cormoran/TPIP3SizeMotorBoard/README.md

# TPIP3SizeMotorBoard
ArduinoUnoCompatible Board for four wheel robot control (with TPIP3 image board)

[Document](https://cormoran.github.io/TPIP3SizeMotorBoard/)
