cormoran/TPIP3SizeMotorBoard/hardware/readme.md

# 2016年度４号機向け モータ制御回路

## 機能

* ４つのモータを正転、逆転、停止、空転、速度調整
* ２つのサーボモータを制御
* 赤外線LED, 受信機
* 温度センサー
* 状態表示用LED 2つ
* VCC,GND出力付きアナログ入力対応汎用ポート 4つ （ガスセンサ等を接続可能）
* 汎用ディジタルIOポート 4つ（二つはスイッチとポート兼用）
* スイッチ入力 4つ（２つはIOポート兼用）
* Groveポート(I2C)
* シリアル通信ポート
* バッテリー電圧監視
* USBシリアル変換IC搭載、Arduino DEIによる書き込み対応
* USB給電・バッテリー給電自動切り替え（バッテリー優先）

など

一応2016年度 3号機向けだが、部内ロボコン等にも使用できるように色々付けてある

## 形状

* TPIP3の金属部分と完全に同じ大きさに設計
* ポートは全て横向きに設置することで高さを削減
