cormoran/TPIP3SizeMotorBoard/document/external-library.md

# 依存ライブラリのインストール

以下のライブラリを入れておくと次で入れるサンプルをコンパイルできる

- [Adafruit-PWM-Servo-Driver-Library](https://github.com/adafruit/Adafruit-PWM-Servo-Driver-Library)
- [DHT-sensor-library](https://github.com/adafruit/DHT-sensor-library)
- [IRremote](https://github.com/z3t0/Arduino-IRremote)

MacのArduinoIDEなら以下のようにたどってライブラリマネージャを開く．

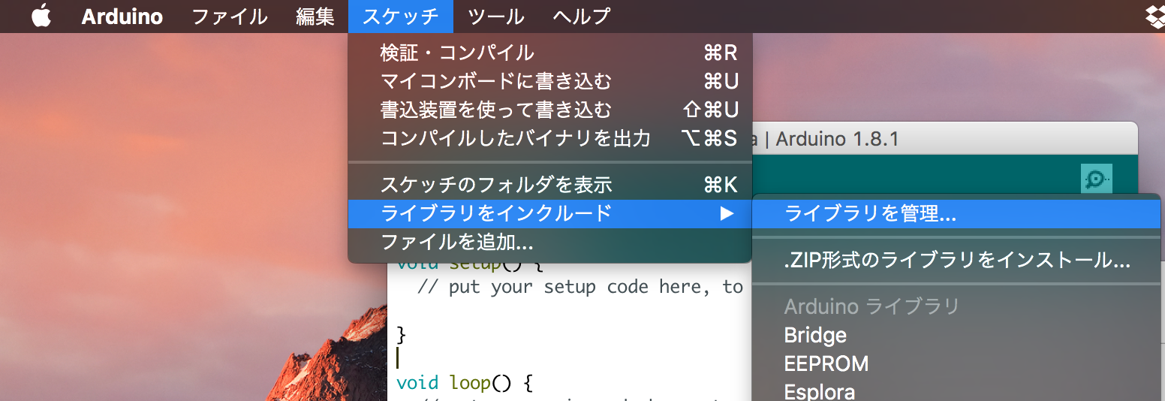
[picture p3: document/assets/library-manager.png]


それっぽく検索すると出てくるのでインストールを押すと勝手に入れてくれる．
