cormoran/TPIP3SizeMotorBoard/document/SUMMARY.md

# TPIP3サイズのArduino互換ボード

* [イントロダクション](README.md)
* [必要な部品](parts.md)
* [制作方法](build.md)
* [ArduinoIDEのインストール](arduino-ide.md)
* [依存ライブラリのインストール](external-library.md)
* [ボードの登録](assign-board.md)
* [テストプログラムの実行](test-program.md)
* [ライブラリのリファレンス](library.md)

---

* 関連リンク

    * [Github](https://github.com/cormoran/TPIP3SizeMotorBoard)
    * [神戸大学ロボット研究会](http://rokko-oroshi.xrea.jp)
    * [TPIP Wiki](http://wiki.tpip-dev.org)
    * [レスキューロボットコンテスト](https://www.rescue-robot-contest.org)

---

* [ノート](note.md)
