cormoran/TPIP3SizeMotorBoard/docs/arduino-ide.md

# Arduino IDEのインストール

インストールしましょう．

[多分ここから可能](https://www.arduino.cc/en/Main/Software)

内部分裂で ardino.cc と arduino.org があって，両方からダウンロードできるが，色々ちょっと違うと思われる．
