cormoran/TPIP3SizeMotorBoard/docs/_book/note.md

# 設計時の話

- Kicadで設計（それまでeagle使いだったが，基板サイズ制限で移行）
- elecrowに発注（自分はelecrowとSwitchSciencePCBしか使ったことない）
- 突貫設計なので...
