cormoran/TPIP3SizeMotorBoard/docs/_book/assets/board_back.jpg

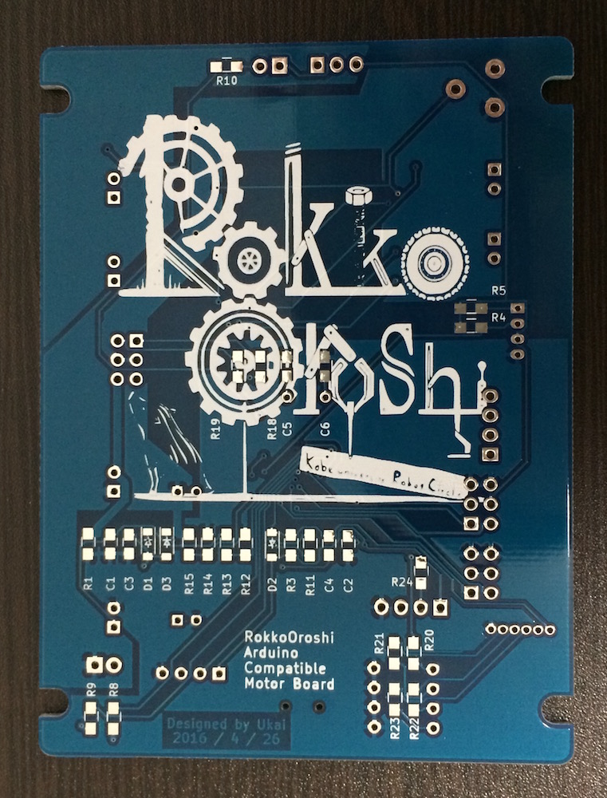
docs/_book/assets/board_back.jpg
