cormoran/TPIP3SizeMotorBoard/docs/_book/assets/board_front.jpg

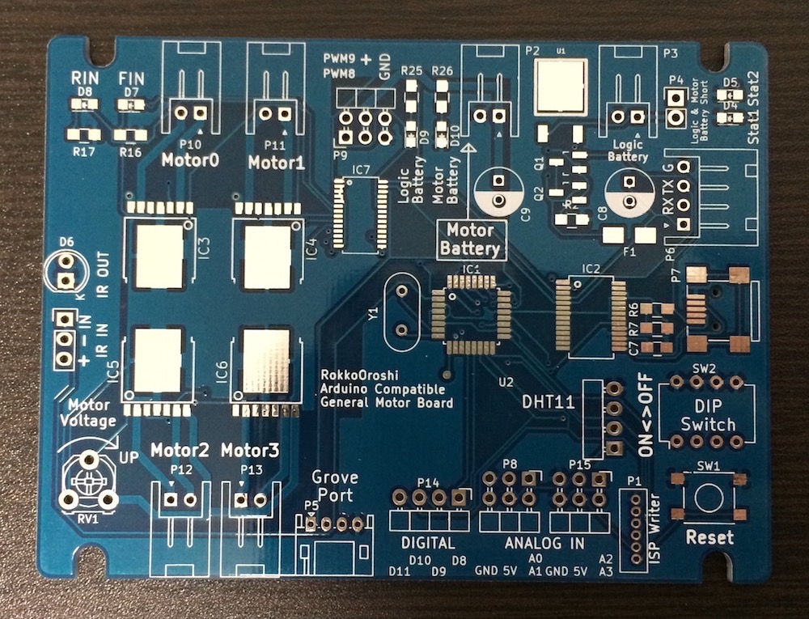
docs/_book/assets/board_front.jpg
