cormoran/TPIP3SizeMotorBoard/hardware/board_front.jpg

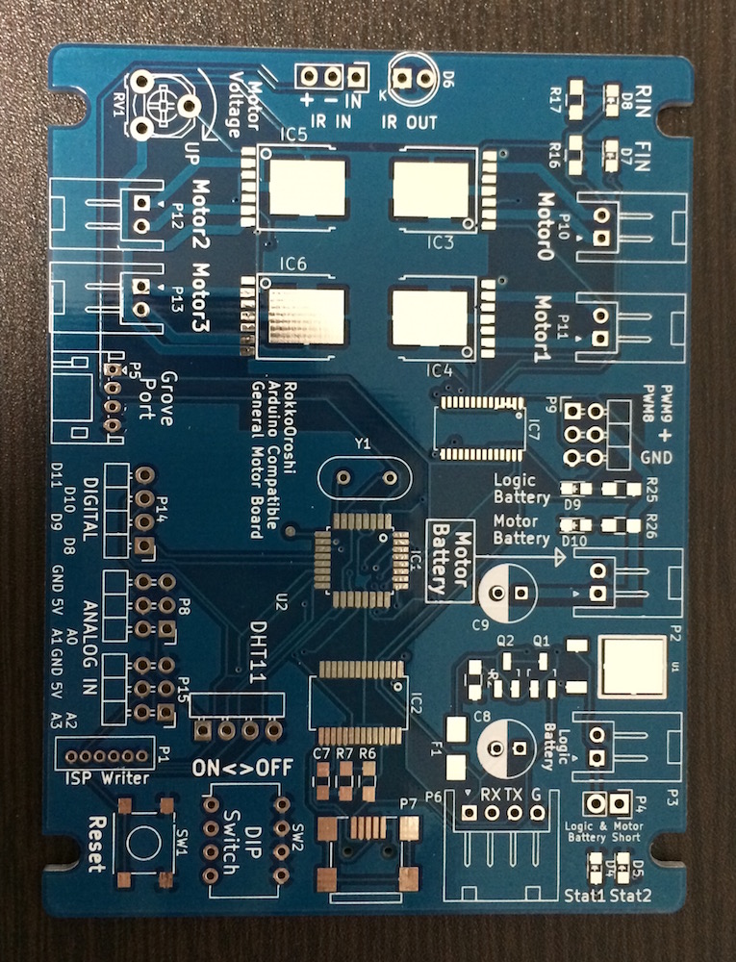
hardware/board_front.jpg
