cormoran/TPIP3SizeMotorBoard/docs/build.md

# 制作方法

昔書き殴った文章そのままです．

1. チップ抵抗の取り付け

    パーツリストの抵抗R1~R26を取り付ける

    R1はモーターのGNDとマイコン側のGNDを接続するためのブリッジで、半田でジャンプしておけば良い

    抵抗は熱に強く、極性がないので、ここで小さい部品の半田付けに慣れる。

	チップ部品は、基板の片方のランドに半田を先につけておいて、それを溶かしながらチップの片方を載せる（文では書きにくい）、その後もう片方を半田付けする、という方法がやりやすいと思う。

2. チップコンデンサの取り付け

	 抵抗と同様の要領でコンデンサC1~C7を取り付ける。

3. ダイオードの取り付け（極性あり）

    D1~D3にチップダイオードを取り付ける。極性があるので注意（線の位置を基板の絵と合わせれば良いはず）

4. LEDの取り付け（極性あり、熱に特に弱い）

	D4~D10にチップダイオードを取り付ける。極性がある&熱に特に弱いので注意。

    また、色が違うとLEDに印刷されたマークが同じなのに極が逆になっているということがあるので注意！！

5. その他部品の取り付け

	 一通り取り付けて慣れてきたはずなので好きな順につけていけば良い。

	気をつける点として、熱に弱い部品はできるだけ後にする、極性がある部品は注意する、他の部品の取り付けの邪魔になるような部品はできるだけ後回しにする、等。

	マイコン等のICは、先にランドに半田を塗っておいて、パーツを上に乗せて、半田ごてを押し付けて溶かしつけるのが、ブリッジしにくくて良いと思う。

    オススメの順番（適当）

    - モータードライバ
    - 電圧変換IC（三端子レギュレータ）
    - FET
	- ポリスイッチ

    - atmega328p
    - PCA9685
    - FT232RL
	
    - その他の表面実装部品
	- USB
    - その他の大きい部品
