cormoran/TPIP3SizeMotorBoard/hardware/board-back.pdf

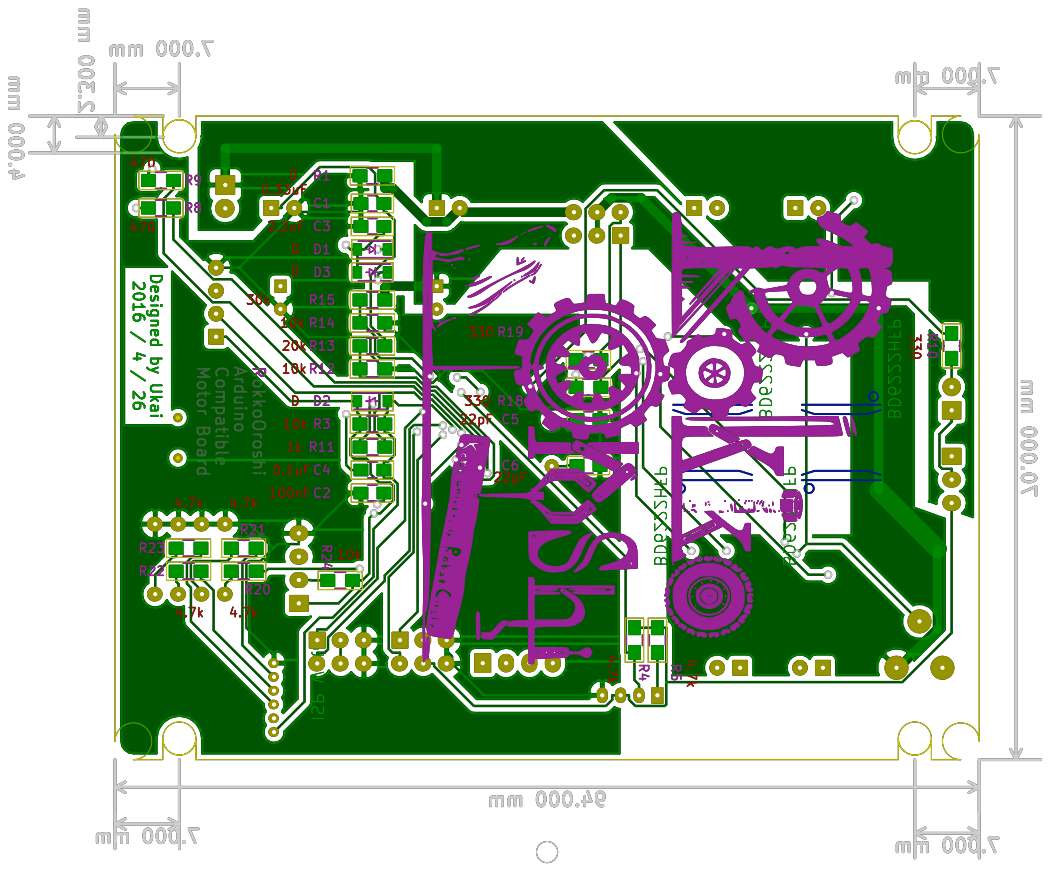
[picture p10: page 1]
