cormoran/TPIP3SizeMotorBoard/hardware/board-front.pdf

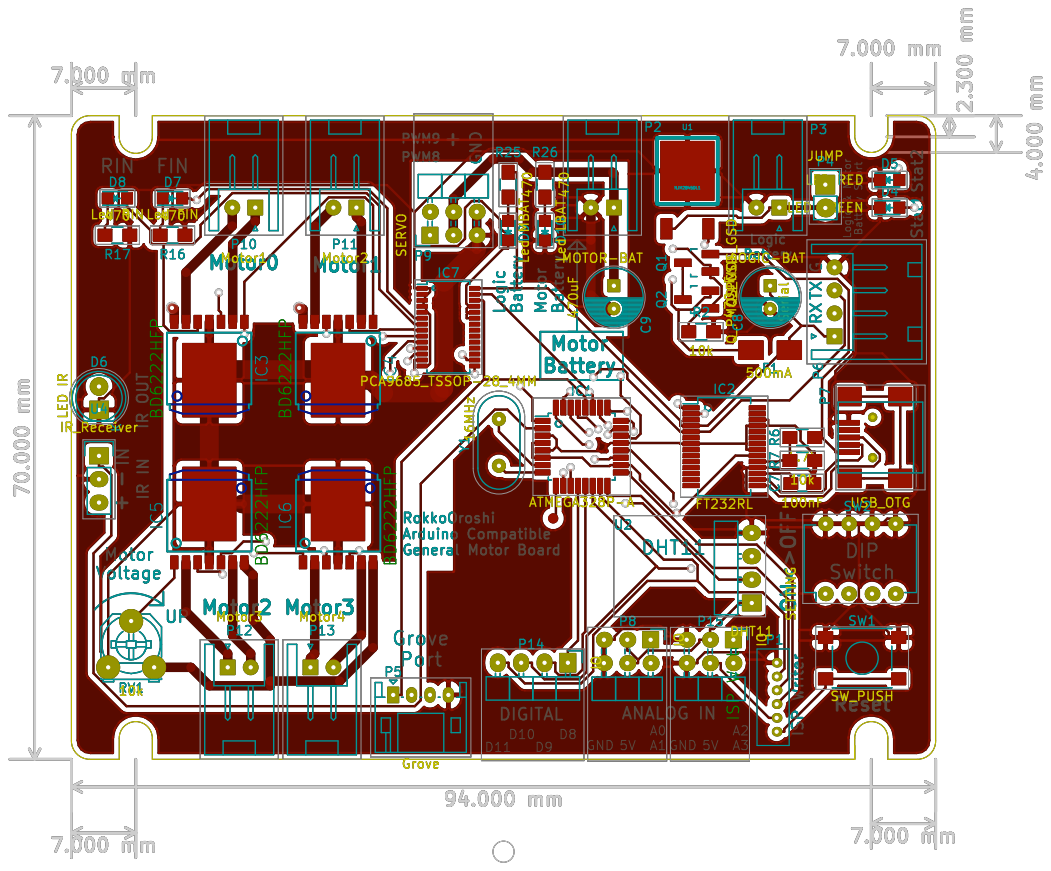
[picture p11: page 1]
