cormoran/TPIP3SizeMotorBoard/docs/assets/sch.pdf

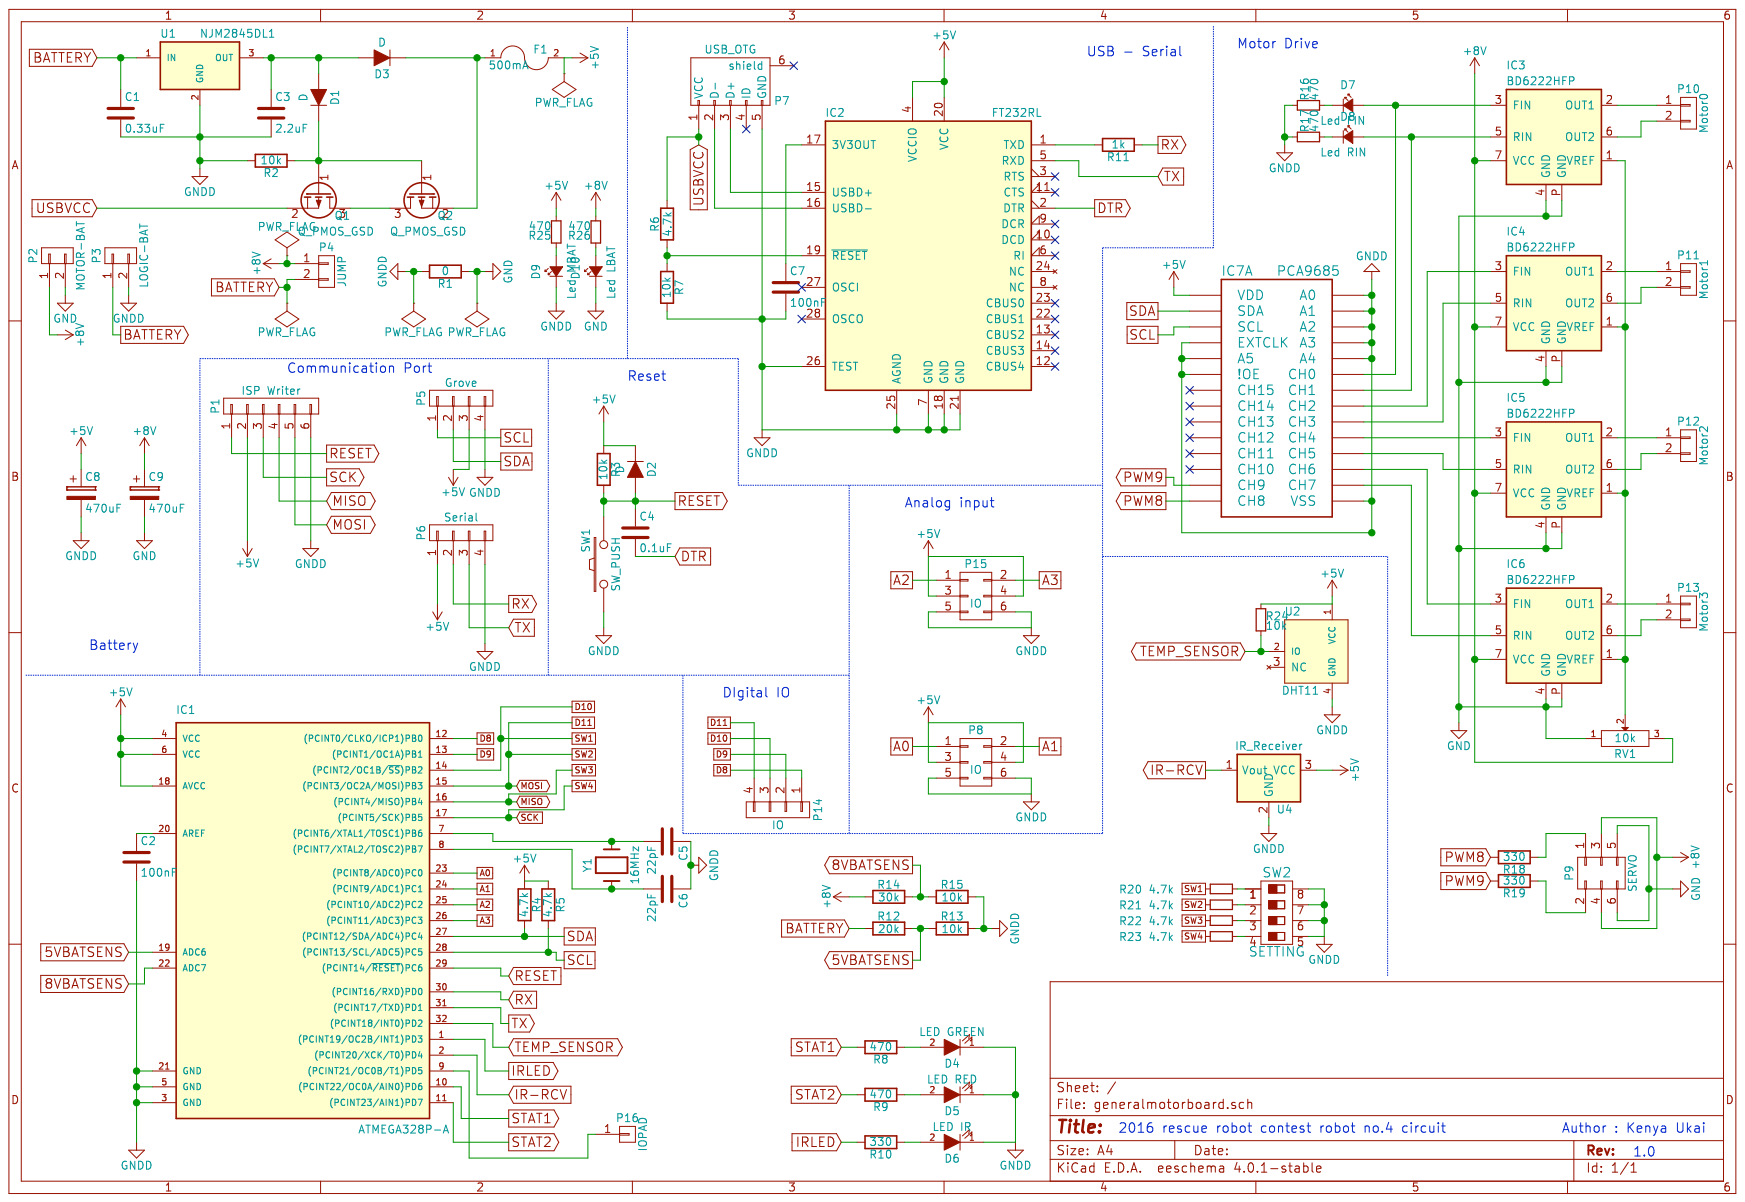
[picture p12: page 1]
