cormoran/TPIP3SizeMotorBoard/(list of files, drawings)

Other design files:
hardware/generalmotorboard.dsn
