cormoran/TPIP3SizeMotorBoard/hardware/generalmotorboard.kicad_pcb

## KiCad design hardware/generalmotorboard.kicad_pcb (2016-05-10)

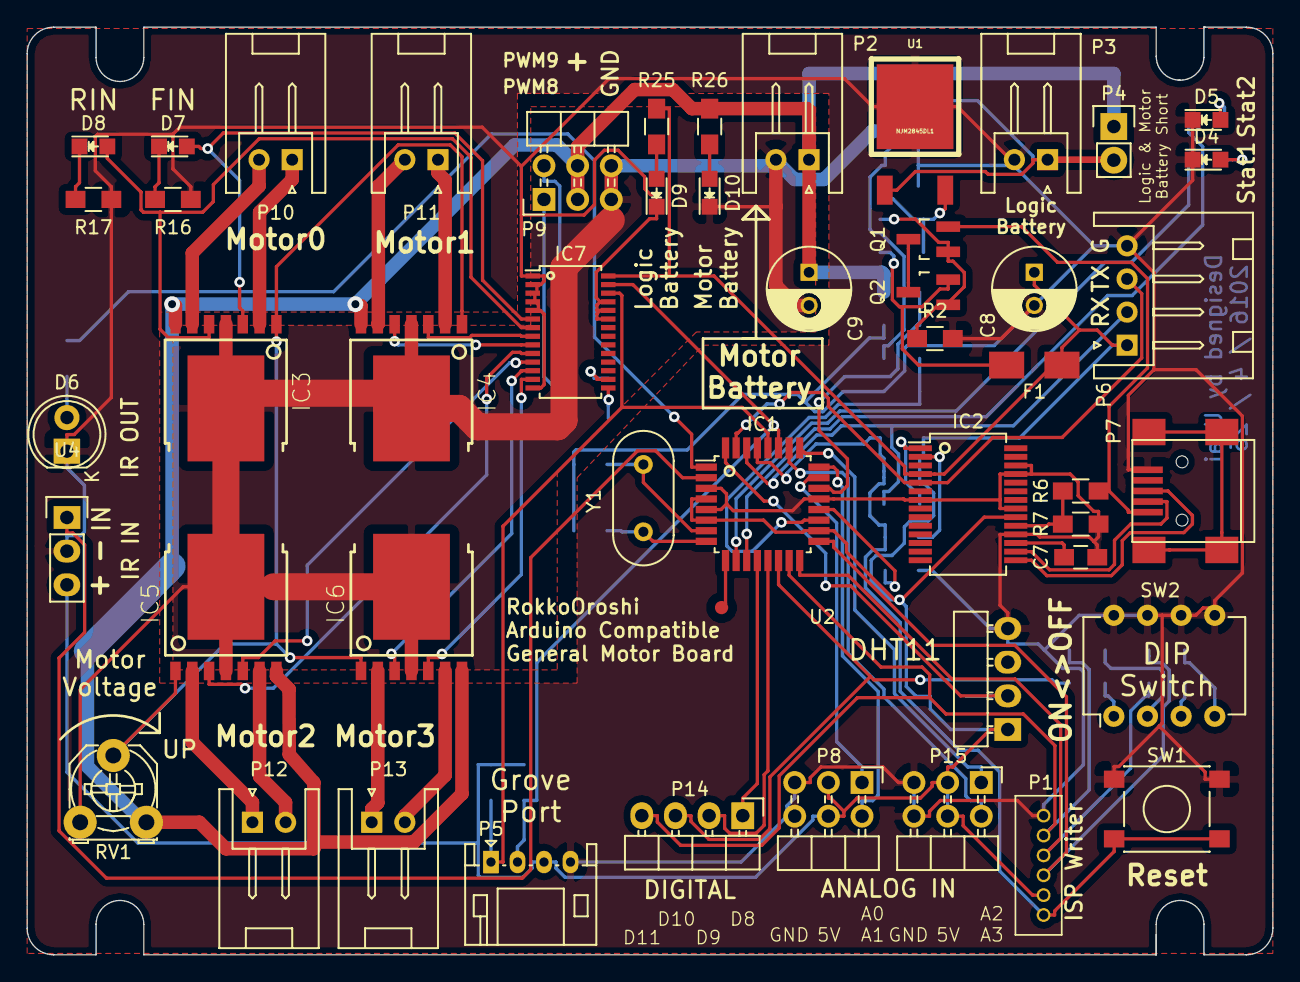
[picture p13: board generalmotorboard.kicad_pcb from above]

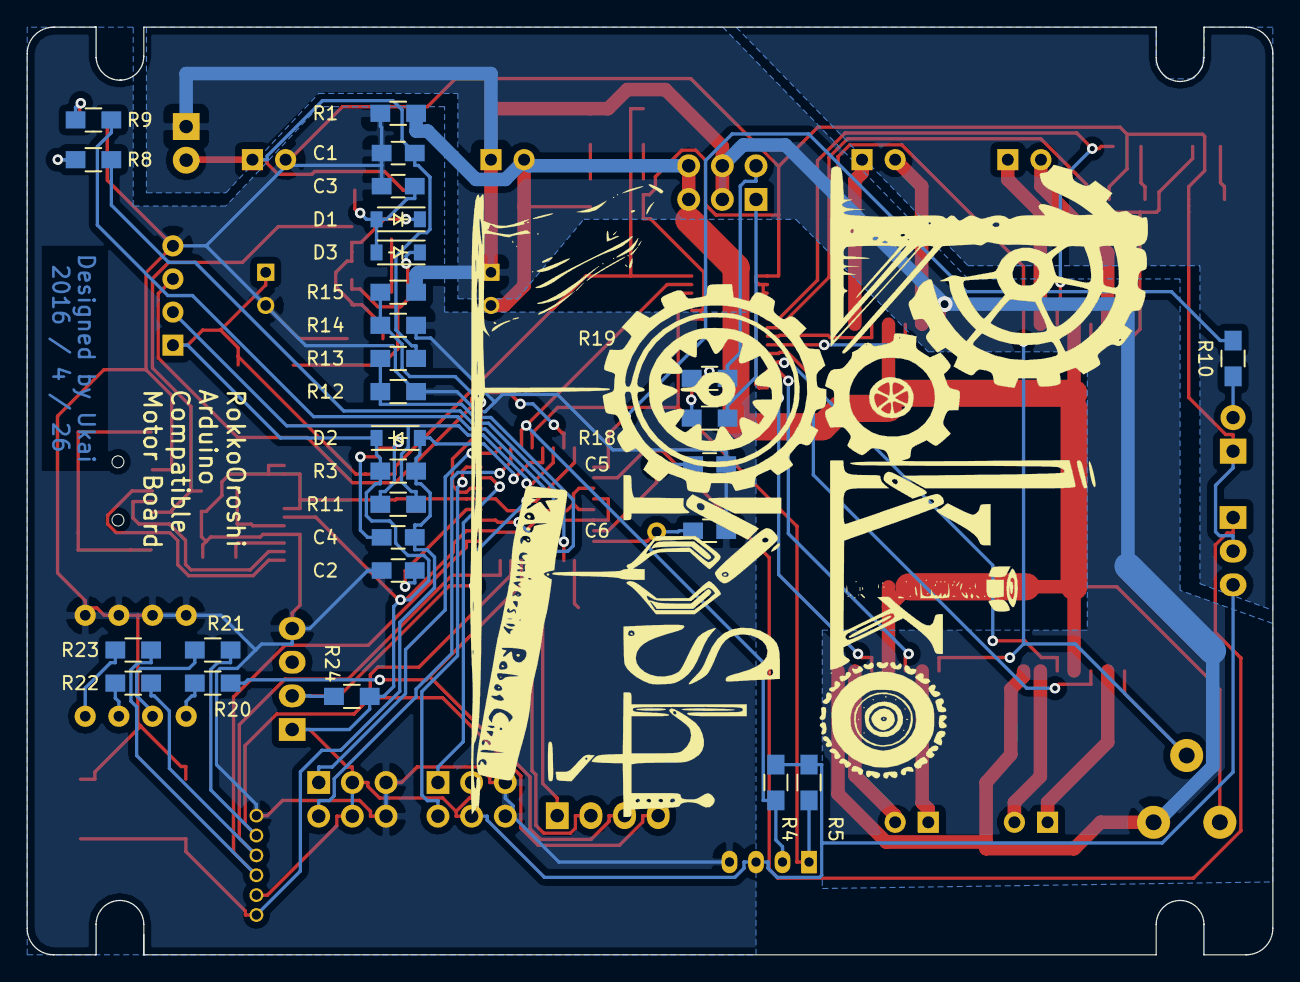
[picture p14: board generalmotorboard.kicad_pcb from below]

Board: 2 copper layers, 94.0 x 70.0 mm, 78 parts (28 on the bottom side), 74 nets.

Parts:
C1: 0.33uF; C_0805_HandSoldering
C2, C7: 100nF; C_0805_HandSoldering
C3: 2.2uF; C_0805_HandSoldering
C4: 0.1uF; C_0805_HandSoldering
C5, C6: 22pF; C_0805_HandSoldering
C8, C9: 470uF; C_Radial_D6.3_L11.2_P2.5
D1, D2, D3: D; SOD-123
D4: LED GREEN; LED_0805
D5: LED RED; LED_0805
D6: LED IR; LED-5MM
D7: Led FIN; LED_0805
D8: Led RIN; LED_0805
D9: Led MBAT; LED_0805
D10: Led LBAT; LED_0805
F1: 500mA; Fuse_SMD1206_HandSoldering
IC1: ATMEGA328P-A; TQFP-32_7x7mm_Pitch0.8mm
IC2: FT232RL; SSOP-28_5.3x10.2mm_Pitch0.65mm
IC3, IC4, IC5, IC6: BD6222HFP; HRP7
IC7: PCA9685_TSSOP-28_4MM; TSSOP-28_4.4x9.7mm_Pitch0.65mm
P1: ISP Writer; B6B-ZR
P2: MOTOR-BAT; JST_XH_S2B-XH-A_02x2.50mm_Angled
P3: LOGIC-BAT; JST_XH_S2B-XH-A_02x2.50mm_Angled
P4: JUMP; Pin_Header_Straight_1x02
P5: Grove; JST_PH_S4B-PH-K_04x2.00mm_Angled
P6: Serial; JST_XH_S4B-XH-A_04x2.50mm_Angled
P7: USB_OTG; USB_Mini-B
P8, P15: IO; Pin_Header_Angled_2x03_without_pin_show
P9: SERVO; Pin_Header_Angled_2x03_without_pin_show
P10: Motor1; JST_XH_S2B-XH-A_02x2.50mm_Angled
P11: Motor2; JST_XH_S2B-XH-A_02x2.50mm_Angled
P12: Motor3; JST_XH_S2B-XH-A_02x2.50mm_Angled
P13: Motor4; JST_XH_S2B-XH-A_02x2.50mm_Angled
P14: IO; Pin_Header_Angled_1x04_without_pin_show
P16: IOPAD; Fiducial_Mark
Q1, Q2: Q_PMOS_GSD; SOT-23_Handsoldering
R1: 0; R_0805_HandSoldering
R2, R3, R7, R13, R15, R24: 10k; R_0805_HandSoldering
R4, R5, R6, R20, R21, R22, R23: 4.7k; R_0805_HandSoldering
R8, R9, R16, R17, R25, R26: 470; R_0805_HandSoldering
R10, R18, R19: 330; R_0805_HandSoldering
R11: 1k; R_0805_HandSoldering
R12: 20k; R_0805_HandSoldering
R14: 30k; R_0805_HandSoldering
RV1: 10k; Potentiometer_Triwood_RM-065
SW1: SW_PUSH; SW_SPST_PTS645
SW2: SETTING; DIP-8_W7.62mm
U1: NJM2845DL1; TO-252-3
U2: DHT11
U4: IR_Receiver; Pin_Header_Straight_1x03
Y1: 16MHz; HC-49V

Connections:
5VBATSENS: IC1.19, R12.2, R13.1
8VBATSENS: IC1.22, R14.2, R15.1
+5V: C8.1, D2.1, F1.2, IC1.4, IC1.6, IC1.18, IC2.4, IC2.20, IC7.28, P1.2, P5.3, P6.1, P8.3, P8.4, P15.3, P15.4, R3.1, R4.1, R5.1, R24.1, R25.2, U2.1, U4.3
+8V: C9.1, IC3.7, IC4.7, IC5.7, IC6.7, P2.1, P4.1, P9.3, P9.4, R14.1, R26.2, RV1.3
A0: IC1.23, P8.1
A1: IC1.24, P8.2
A2: IC1.25, P15.1
A3: IC1.26, P15.2
BATTERY: C1.1, P3.1, P4.2, R12.1, U1.1
D8: IC1.12, P14.1
D9: IC1.13, P14.2
D10: IC1.14, P14.3, R20.1
D11: IC1.15, P1.5, P14.4, R21.1
DTR: C4.2, IC2.2
GND: C9.2, D10.1, IC3.4, IC3.P, IC4.4, IC4.P, IC5.4, IC5.P, IC6.4, IC6.P, P2.2, P9.5, P9.6, R1.1, RV1.1
GNDD: C1.2, C2.2, C3.2, C5.1, C6.1, C7.2, C8.2, D4.1, D5.1, D6.1, D9.1, IC1.3, IC1.5, IC1.21, IC2.7, IC2.18, IC2.21, IC2.25, IC2.26, IC7.1, IC7.2, IC7.3, IC7.4, IC7.5, IC7.14, IC7.23, IC7.24, IC7.25, P1.6, P3.2, P5.4, P6.4, P7.5, P8.5, P8.6, P15.5, P15.6, R1.2, R2.2, R7.2, R13.2, R15.2, R16.1, R17.1, SW1.1, SW2.5, SW2.6, SW2.7, SW2.8, U1.2, U2.4, U4.2
IR-RCV: IC1.2, U4.1
IRLED: IC1.1, R10.2
MISO: IC1.16, P1.4, R22.1
unnamed: C2.1, IC1.20
unnamed: C3.1, D1.2, D3.2, U1.3
unnamed: C5.2, IC1.7, Y1.1
unnamed: C6.2, IC1.8, Y1.2
unnamed: C7.1, IC2.17
unnamed: D1.1, Q1.1, Q2.1, R2.1
unnamed: D3.1, F1.1, Q2.2
unnamed: D4.2, R8.1
unnamed: D5.2, R9.1
unnamed: D6.2, R10.1
unnamed: D7.1, R16.2
unnamed: D7.2, IC3.3, IC7.6
unnamed: D8.1, R17.2
unnamed: D8.2, IC3.5, IC7.7
unnamed: D9.2, R25.1
unnamed: D10.2, R26.1
unnamed: IC1.9, P16.1
unnamed: IC2.1, R11.2
unnamed: IC2.15, P7.3
unnamed: IC2.16, P7.2
unnamed: IC2.19, R6.1, R7.1
unnamed: IC3.1, IC4.1, IC5.1, IC6.1, RV1.2
unnamed: IC3.2, P10.1
unnamed: IC3.6, P10.2
unnamed: IC4.2, P11.1
unnamed: IC4.3, IC7.8
unnamed: IC4.5, IC7.9
unnamed: IC4.6, P11.2
unnamed: IC5.2, P12.1
unnamed: IC5.3, IC7.10
unnamed: IC5.5, IC7.11
unnamed: IC5.6, P12.2
unnamed: IC6.2, P13.1
unnamed: IC6.3, IC7.12
unnamed: IC6.5, IC7.13
unnamed: IC6.6, P13.2
unnamed: P9.1, R18.1
unnamed: P9.2, R19.1
unnamed: Q1.3, Q2.3
unnamed: R20.2, SW2.1
unnamed: R21.2, SW2.2
unnamed: R22.2, SW2.3
unnamed: R23.2, SW2.4
PWM8: IC7.15, R18.2
PWM9: IC7.16, R19.2
RESET: C4.1, D2.2, IC1.29, P1.1, R3.2, SW1.2
RX: IC1.30, P6.2, R11.1
SCK: IC1.17, P1.3, R23.1
SCL: IC1.28, IC7.26, P5.1, R5.2
SDA: IC1.27, IC7.27, P5.2, R4.2
STAT1: IC1.10, R8.2
STAT2: IC1.11, R9.2
TEMP_SENSOR: IC1.32, R24.2, U2.2
TX: IC1.31, IC2.5, P6.3
USBVCC: P7.1, Q1.2, R6.2
