cormoran/TPIP3SizeMotorBoard/(commit log)

2016-05-15 基板画像等追加
2016-05-15 ライブラリ・サンプル等（まだ一部のみ）追加
2017-02-05 リンクなど追加
2017-02-05 modify sample
